willipe53/CatFeeder/FeederSchematic.pdf

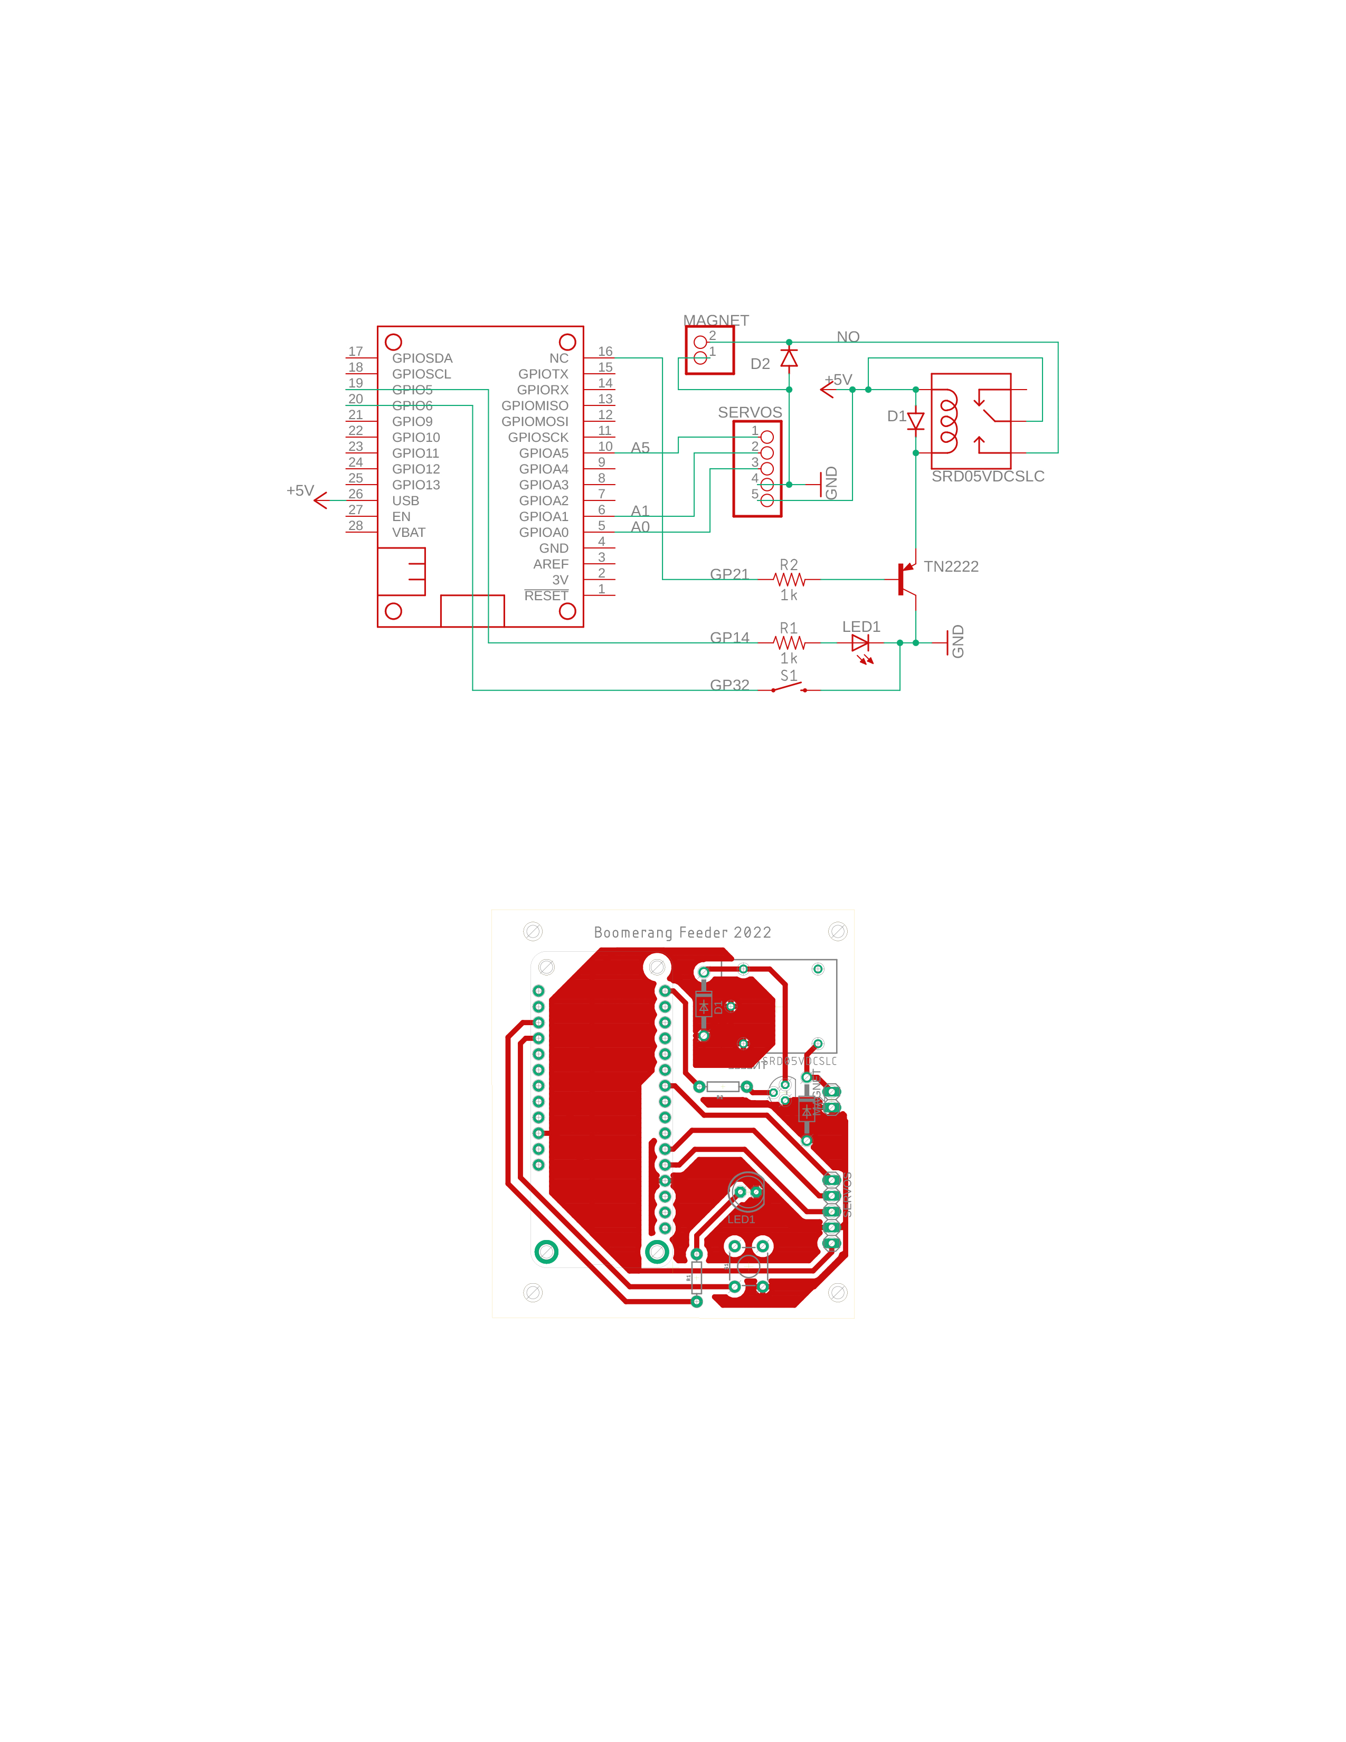
[picture p2: page 1]
